repollo/EcoSprayDrone/Electronics_rpi_pump.pdf

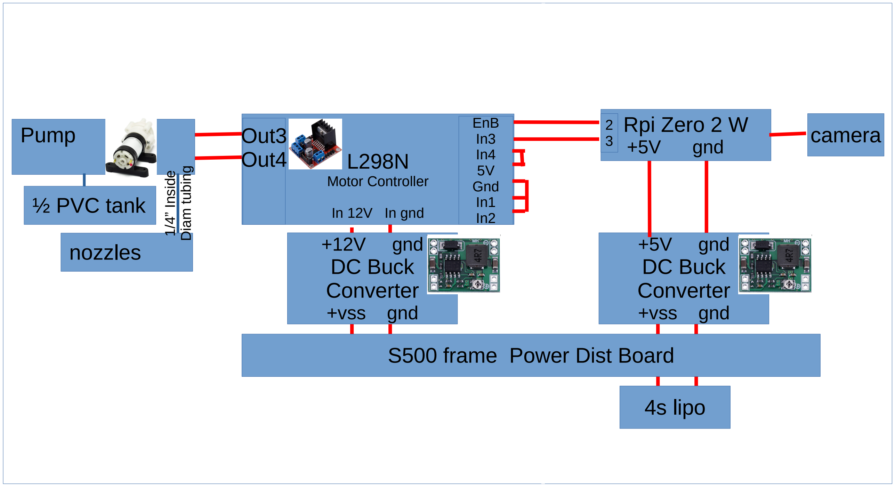
[picture p2: figure]
gnd; DC Buck Converter +vss gnd; 4s lipo; S500 frame Power Dist Board; Motor Controller; In 12V In gnd; Out3 Out4; EnB In3 In4 5V Gnd In1 In2; Pump; ½ PVC tank; nozzles; sid; Dia; bin; Rpi Zero 2 W; camera
