repollo/EcoSprayDrone/BOM.xlsx

Sheet: Landing Pad - Checklist
Checklist
Yes/No | Description | Quantity | Amount
TRUE | 4'x8 1/2" plywood | 2 | $36.00
TRUE | 2"x4"x8' lumber | 8 | $24.00
TRUE | 2"x6"x8' lumber | 2 | $11.00
TRUE | 2"x2"x8' lumber | 6 | $17.00
TRUE | 1/2"x10' threaded rod | 3 | $40.00
TRUE | Makermotor 3/8" D Shaft 12V DC Reversible Electric Gear Motor 100 RPM (https://www.amazon.com/gp/product/B07...) (https://www.youtube.com/redirect?event=video_description&v=Q7A3PlqpgYs) | 3 | $240.00
TRUE | 1/2" course threaded nuts | 25 | $7.00
TRUE | 3" screws 5lb bucket | 1 | $23.00
TRUE | 50' roll 18-2 wire | 2 | $16.00
TRUE | container wire nuts | 1 | $10.00
TRUE | goop adhesive | 1 | $5.00
TRUE | 4'x8 1/2" plywood | 1 | $18.00
TRUE | 2"x2"x8' lumber | 6 | $17.00
TRUE | 14" linear actuator (https://www.amazon.com/gp/product/B07...) (https://www.youtube.com/redirect?event=video_description&v=Q7A3PlqpgYs) | 2 | $98.00
TRUE | 16" linear actuator (same link as above) | 1 | $50.00
TRUE | 4" linear actuator (same link as above) | 1 | $36.00
TRUE | 4s lipo battery charger (https://www.amazon.com/gp/product/B07...) (https://www.youtube.com/redirect?event=video_description&v=Q7A3PlqpgYs) | 1 | $15.00
TRUE | roll thick copper tape (https://www.amazon.com/gp/product/B09...) (https://www.youtube.com/redirect?event=video_description&v=Q7A3PlqpgYs) | 1 | $17.00
TRUE | 1" screws 1 lb container | 1 | $5.00
TRUE | 10A Cytron dual motor controller (ESC) (https://www.amazon.com/gp/product/B07...) (https://www.youtube.com/redirect?event=video_description&v=Q7A3PlqpgYs) | 4 | $96.00
TRUE | Arduino Uno (https://www.amazon.com/Arduino-A00006...) (https://www.youtube.com/redirect?event=video_description&v=Q7A3PlqpgYs) | 1 | $29.00
TRUE | 20A 12V power supply (https://www.amazon.com/gp/product/B07...) (https://www.youtube.com/redirect?event=video_description&v=Q7A3PlqpgYs) | 1 | $23.00
TRUE | Electrical power strip | 1 | $5.00
TRUE | Laptop (not included in price - use one you have) | 1
 | *Where no link is given, go to your local hardware store (Menards in my case) to buy. |  | $838.00

Sheet: Drone - Checklist
Checklist
Yes/No | Description | Quantity | Amount
TRUE | S500 frame Drone (https://www.amazon.com/gp/product/B01...) (https://www.youtube.com/redirect?event=video_description&v=Q7A3PlqpgYs) | 1 | $48.00
TRUE | 30A ESC (https://www.amazon.com/gp/product/B07...) (https://www.youtube.com/redirect?event=video_description&v=Q7A3PlqpgYs) | 4 | $40.00
TRUE | 920kV drone motors (https://www.amazon.com/gp/product/B09...) (https://www.youtube.com/redirect?event=video_description&v=Q7A3PlqpgYs) | 4 | $40.00
TRUE | two-pair drone props | 1 | $14.00
TRUE | Cube orange, 1 here 3+ GPS, 1 900MHz radio (https://irlock.com/collections/combos...) (https://www.youtube.com/redirect?event=video_description&v=Q7A3PlqpgYs) | 1 | $679.00
TRUE | tf-mini (lidar - optional) (https://irlock.com/collections/rangef...) (https://www.youtube.com/redirect?event=video_description&v=Q7A3PlqpgYs) | 1 | $50.00
TRUE | Balsa wood | 1 | $10.00
TRUE | wood glue | 1 | $5.00
TRUE | zip ties | 1 | $5.00
TRUE | adhesive velcro | 1 | $5.00
TRUE | 4s 5200 mAH lipo Battery (https://www.amazon.com/Zeee-Battery-5...) (https://www.youtube.com/redirect?event=video_description&v=Q7A3PlqpgYs) | 2 | $98.00
TRUE | liquid electrical tape | 1 | $5.00
 | Total |  | $999.00

Sheet: Sprayer - Checklist
Checklist
Yes/No | Description | Quantity | Amount
TRUE | L298N Motor Controller (https://www.amazon.com/Qunqi-Controll...) (https://www.youtube.com/redirect?event=video_description&v=Fflbc_y2IGQ) | 1 | $7.00
TRUE | 12V and 5V DC buck converter (adjustable) (https://www.amazon.com/dp/B01MQGMOKI?...) (https://www.youtube.com/redirect?event=video_description&v=Fflbc_y2IGQ) | 1 | $12.00
TRUE | Sprayer Pump (https://www.amazon.com/gp/product/B07...) (https://www.youtube.com/redirect?event=video_description&v=Fflbc_y2IGQ) | 1 | $10.00
TRUE | Nozzle (https://www.amazon.com/Hourleey-Misti...) (https://www.youtube.com/redirect?event=video_description&v=Fflbc_y2IGQ) | 1 | $8.00
TRUE | Nozzle tubing (https://www.amazon.com/REDTRON-Distri...) (https://www.youtube.com/redirect?event=video_description&v=Fflbc_y2IGQ) | 1 | $8.00
TRUE | 5' section of 1/2" PVC, 6 90 degree connectors, 4 T connectors, silicon, 1/4" inside diameter tubing - $25 (tank/landing gear) | 1 | $25.00
 | *Where no link is given, go to your local hardware store (Menards in my case) to buy. |  | $70.00

Sheet: Camera system V2 - Checklist
Checklist
Yes/No | Description | Quantity | Amount
TRUE | Raspberry Pi Zero 2 W (https://www.raspberrypi.com/products/...) (https://www.youtube.com/redirect?event=video_description&v=Fflbc_y2IGQ) | 1 | $15.00
TRUE | Raspberry Pi Camera 2 (https://www.raspberrypi.com/products/...) (https://www.youtube.com/redirect?event=video_description&v=Fflbc_y2IGQ) | 1 | $25.00
 | *Where no link is given, go to your local hardware store (Menards in my case) to buy. |  | $40.00

Sheet: Camera system V1 OBSOLETE - Che
Checklist
Yes/No | Description | Quantity | Amount
TRUE | *NOTE I don't recommend buying version 1. Version 2 will be WAY better and cheaper. Just wait for raspberri pi to be back in stock*
TRUE | 1 Runcam swift 2 FPV Camera - $28 (https://usa.banggood.com/RunCam-Swift...) (https://www.youtube.com/redirect?event=video_description&v=Fflbc_y2IGQ) | 1 | $28.00
TRUE | 1 eachine 5.8GHz Video Transmitter TX805S - $35 (https://usa.banggood.com/Eachine-TX80...) (https://www.youtube.com/redirect?event=video_description&v=Fflbc_y2IGQ) | 1 | $35.00
TRUE | 1 eachine ROTG02 5.8GHz receiver w/ USB - $31 (https://www.banggood.com/Eachine-ROTG...) (https://www.youtube.com/redirect?event=video_description&v=Fflbc_y2IGQ) | 1 | $31.00
 | *Where no link is given, go to your local hardware store (Menards in my case) to buy. |  | $94.00
