repollo/EcoSprayDrone/webcamCapture.py

import cv2
import os

# May have to run as admin?
# Save photos here so we can crop and process
os.chdir('C:\\Users\\naNU\\Desktop\\drone\\ia_predict\\')

cam = cv2.VideoCapture(0)

cv2.namedWindow("test")

img_counter = 0

while True:
    ret, frame = cam.read()
    if not ret:
        print("failed to grab frame")
        break
    cv2.imshow("test", frame)

    k = cv2.waitKey(1)
    if k%256 == 27:
        # ESC pressed
        print("Escape hit, closing...")
        break
    elif k%256 == 32:
        # SPACE pressed
        img_name = "opencv_frame_{}.jpg".format(img_counter)
        cv2.imwrite(img_name, frame)
        print("{} written!".format(img_name))
        img_counter += 1

cam.release()

cv2.destroyAllWindows()
