repollo/EcoSprayDrone/picamera_stub.py

class PiCamera:
    def start_preview(self):
        print("Starting camera preview (stub).")
    
    def capture(self):
        print("Picture Taken (stub).")
    
    def stop_preview(self):
        print("Stopping camera preview (stub).")
    
    # ... add any other methods you use from picamera
